apurvaumredkar/Bluetooth-Hex-Locker/README.md

# Bluetooth-Hex-Locker
The Arduino source file for ATmega32, Proteus simulation and PCB design file, detailed report about the project are included in this repository.\
The main objective of our project is to design a locker system based on hexadecimal-RGB system.\
The password can be manually entered through a keypad or using a smartphone via Bluetooth using the app custom made for this project.
