apurvaumredkar/Bluetooth-Hex-Locker/(list of files, drawings)

Other design files:
Smart Hexadecimal Locker System.pdsprj
